akiofujita/ShaqJr/ShaqJr.docx

Shaq Jr Features

- heart rate
- respiratory rate
- time
- stopwatch
- timer
- plot heart rate
- 8-bit tones
- steps
- calories
- distance traveled
- gps
- mic
- blue tooth - notifications
- humidity
- ambient temperature
- skin temperature
- ambient light?
- Mp3 ?
