akiofujita/ShaqJr/Hardware/Bottom/ShaqJr-BOTTOM-BOM.xlsx

Design Name -- Revision Code / Designer |  |  |  |  |  |  |  |  |  |  | Total | $0.00 | Total (in Bulk) | $0.00
BOM # | Comment | Designator | Description | Mounting Type | Package | Manufacturer | Manufacturer Part Number | Supplier | Supplier Part Number | Price per unit | Quantity | Total | Per 100 | Total
1 | 10k resistor | R12, R10, R11 |  |  |  |  |  |  |  |  | 3
2 | 220k resistor | R1, R3, R5, R6 |  |  |  |  |  |  |  |  | 4
3 | 1M resistor | R2, R8 |  |  |  |  |  |  |  |  | 2
4 | 10M resistor | R4, R7 |  |  |  |  |  |  |  |  | 2
5 | unknown resistor | R9 |  |  |  |  |  |  |  |  | 1
6 | 2.2nF capactior | C7, C1 |  |  |  |  |  |  |  |  | 2
7 | 22nF capacitor | C5 |  |  |  |  |  |  |  |  | 1
8 | 100nF capacitor | C3, C6, C4, C10, C13, C12, C11 |  |  |  |  |  |  |  |  | 7
9 | 1uF capacitor | C14 |  |  |  |  |  |  |  |  | 1
10 | 2.2uF capacitor | C8, C9 |  |  |  |  |  |  |  |  | 2
11 | 22uF capacitor | C2 |  |  |  |  |  |  |  |  | 1
12 | crystal | Y1 |  |  |  |  |  |  |  |  | 1
13 | Trasnsitor | Q2 | NPN-GENERIC |  |  |  |  |  |  |  | 1
14 | TIA | TIA |  |  |  |  |  |  |  |  | 1
15 | LSM6DS3 | IMU1 | LSM6DS3_CAST |  |  |  |  |  |  |  | 1
16 | PCF8523 | U1 |  |  |  |  |  |  |  |  | 1
17 | AD5242 | AD5242 |  |  |  |  |  |  |  |  | 1
18 | AD5171 | AD5171 |  |  |  |  |  |  |  |  | 1
19 | Op Amp | OP2G$2, OP2G$3, OP2G$1, OP2G$4 |  |  |  |  |  |  |  |  | 2
20 | CONN_07-1.27MM | J1 |  |  |  |  |  |  |  |  | 1
21 | PPG Module connector | U$1 | Digi-key Part number: S9014E-50-ND |  |  |  |  |  |  |  | 1
