akiofujita/ShaqJr/Hardware/Top/ShaqJr-TOP-BOM.xlsx

Design Name -- Revision Code / Designer |  |  |  |  |  |  |  |  |  |  | Total | $0.00 | Total (in Bulk) | $0.00
BOM # | Comment | Designator | Description | Mounting Type | Package | Manufacturer | Manufacturer Part Number | Supplier | Supplier Part Number | Price per unit | Quantity | Total | Per 100 | Total
1 | 0 resistor | R16, R17 |  |  |  |  |  |  |  |  | 2
2 | 27 resistor | R11, R12 |  |  |  |  |  |  |  |  | 2
3 | 1k resistor | R7, R8, R14, R15 |  |  |  |  |  |  |  |  | 4
4 | 5k resistor | R4 |  |  |  |  |  |  |  |  | 1
5 | 10k resistor | R1, R2, R10, R9 |  |  |  |  |  |  |  |  | 4
6 | 100k resistor | R3, R5, R6 |  |  |  |  |  |  |  |  | 3
7 | 390k resistor | R13 |  |  |  |  |  |  |  |  | 1
8 | 47p capacitor | C10, C11 |  |  |  |  |  |  |  |  | 2
9 | 100nF capacitor | C13, C9 |  |  |  |  |  |  |  |  | 2
10 | 1uF capacitor | C2, C3, C6 |  |  |  |  |  |  |  |  | 3
11 | 2.2uF capacitor | C16, C14, C17, C18, C15 |  |  |  |  |  |  |  |  | 5
12 | 4.7uF capcitor | C1, C8 |  |  |  |  |  |  |  |  | 2
13 | 10uF capacitor | C4, C12 |  |  |  |  |  |  |  |  | 2
14 | unknown capcitor | C5, C7 |  |  |  |  |  |  |  |  | 2
15 | 10uH Inductor | L1 |  |  |  |  |  |  |  |  | 1
16 | Schottky diode | D1, D2, D3 | SCHOTTKY-USC |  |  |  |  |  |  |  | 3
17 | crystal | Y1 |  |  |  |  |  |  |  |  | 1
18 | red LED | LED1, LED3 |  |  |  |  |  |  |  |  | 2
19 | blue LED | LED2 |  |  |  |  |  |  |  |  | 1
20 | yellow LED | LED4 |  |  |  |  |  |  |  |  | 1
21 | nRF52832 module | U1 | Bluetooth module |  |  |  |  |  |  |  | 1
22 | FT231XS | U2 | FTDI Serial-to-USB Converter |  |  |  |  |  |  |  | 1
23 | OLED | U3 | Display |  |  |  |  |  |  |  | 1
24 | MIC5504 | LDO1 | MIC5504 Voltage Regulator |  |  |  |  |  |  |  | 1
25 | Micro USB Pad | USB1 | USB.MICRO-BIGGERPADS |  |  |  |  |  |  |  | 1
26 | MCP73831 | CHRG1 |  |  |  |  |  |  |  |  | 1
27 | CONN_02 | J1 |  |  |  |  |  |  |  |  | 1
28 | CONN_07-1.27MM | J2 |  |  |  |  |  |  |  |  | 1
29 | JUMPER-SMT_2_NO_SILK | JP1 |  |  |  |  |  |  |  |  | 1
30 | CORTEX_DEBUG_PTH | DEBUG1 |  |  |  |  |  |  |  |  | 1
31 | Button Gullwig | SW1, RESET |  |  |  |  |  |  |  |  | 2
32 | Buttons MOM | SW3, SW4 |  |  |  |  |  |  |  |  | 2
