akiofujita/ShaqJr/Hardware/Bottom/ShaqJr-BOTTOM.brd

## EAGLE design Hardware/Bottom/ShaqJr-BOTTOM.brd (2020-07-17)

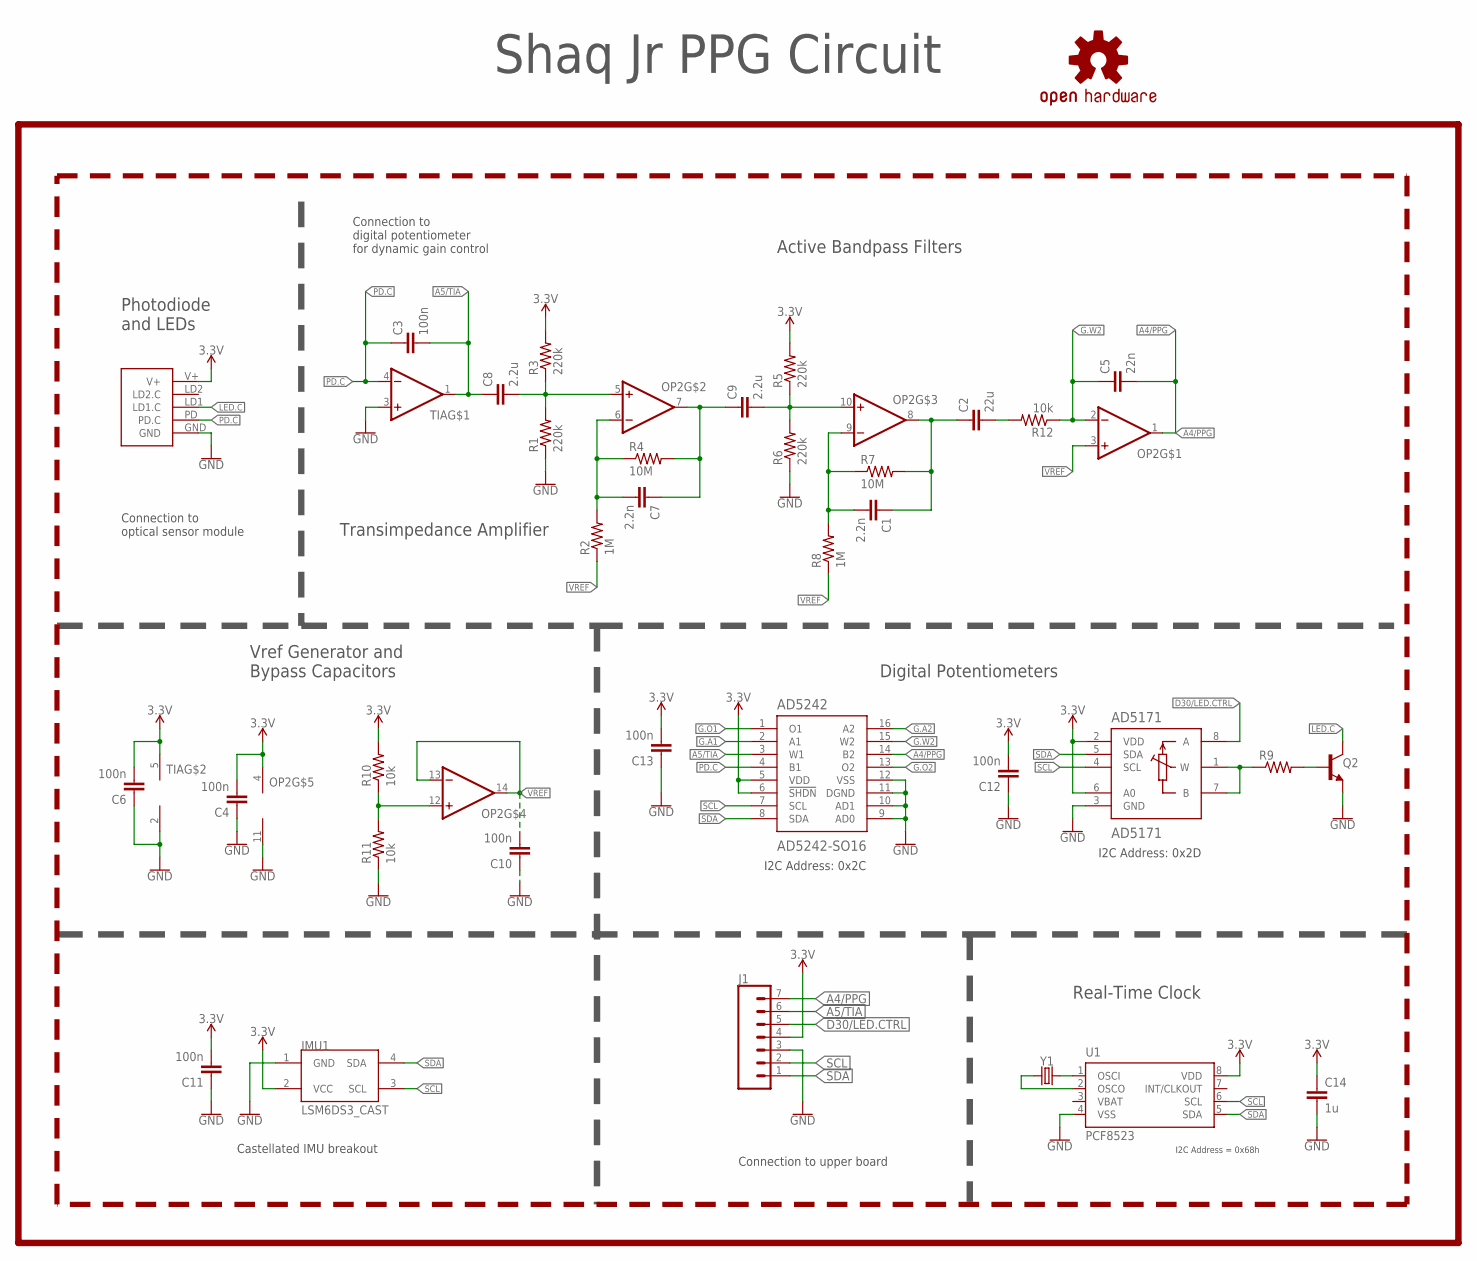
[picture p10: schematic ShaqJr-BOTTOM.sch]

Parts:
AD5171: AD5171; SOT-23-8
AD5242: AD5242-SO16; SO16
C1, C7: 2.2n; C0603
C2: 22u; C0603
C3, C4, C6, C10, C11, C12, C13: 100n; C0603
C5: 22n; C0603
C8, C9: 2.2u; C0603
C14: 1u; C0603
IMU1: LSM6DS3_CAST
J1: CONN_07-1.27MM; 1X07_1.27MM
LOGO1: REVISION.A; REV.A
LOGO2: OSHW-LOGOS; OSHW-LOGO-S
OP2: OP-QUAD-SO14; SO14
Q2: NPN-GENERIC; SOT23-3
R1, R3, R5, R6: 220k; R0603
R2, R8: 1M; R0603
R4, R7: 10M; R0603
R9: RESISTOR0603; R0603
R10, R11: 10k; R0402
R12: 10k; R0603
TIA: OP-SINGLEOT; SOT23-5
U1: PCF8523; SO8; DIGIKEY 568-5306-1-ND
U$1: PPG.MODULE.2
Y1: 32.7680kHz; 2-SMD.NOLEAD.2.0MMTO1.2MM

Connections:
3.3V: AD5171.2 (VDD), AD5171.6 (A0), AD5242.5 (VDD), AD5242.6 (!SHDN), C4.2, C6.2, C11.2, C12.2, C13.2, C14.1, IMU1.2 (VCC), J1.4, OP2.4 (V+), R3.2, R5.2, R10.2, TIA.5 (V+), U1.8 (VDD), U$1.V+
A4/PPG: AD5242.14 (B2), C5.2, J1.7, OP2.1 (OUT)
A5/TIA: AD5242.3 (W1), C3.2, C8.1, J1.6, TIA.1 (OUT)
D30/LED.CTRL: AD5171.8 (A), J1.5
G.A1: AD5242.2 (A1)
G.A2: AD5242.16 (A2)
G.O1: AD5242.1 (O1)
G.O2: AD5242.13 (O2)
G.W2: AD5242.15 (W2), C5.1, OP2.2 (-IN), R12.1
GND: AD5171.3 (GND), AD5242.9 (AD0), AD5242.10 (AD1), AD5242.11 (DGND), AD5242.12 (VSS), C4.1, C6.1, C10.1, C11.1, C12.1, C13.1, C14.2, IMU1.1 (GND), J1.3, OP2.11 (V-), Q2.2 (E), R1.1, R6.1, R11.1, TIA.2 (V-), TIA.3 (+IN), U1.4 (VSS), U$1.GND
LED.C: Q2.3 (C), U$1.LD1 (LD1.C)
unnamed: C8.2, OP2.5 (+IN), R1.2, R3.1
unnamed: C9.2, OP2.10 (+IN), R5.1, R6.2
unnamed: C7.2, OP2.6 (-IN), R2.2, R4.1
unnamed: C7.1, C9.1, OP2.7 (OUT), R4.2
unnamed: C1.2, OP2.9 (-IN), R7.1, R8.2
unnamed: C1.1, C2.1, OP2.8 (OUT), R7.2
unnamed: C2.2, R12.2
unnamed: U1.2 (OSCO), Y1.P$1 (1)
unnamed: U1.1 (OSCI), Y1.P$2 (2)
unnamed: Q2.1 (B), R9.2
unnamed: AD5171.1 (W), AD5171.7 (B), R9.1
unnamed: OP2.12 (+IN), R10.1, R11.2
PD.C: AD5242.4 (B1), C3.1, TIA.4 (-IN), U$1.PD (PD.C)
SCL: AD5171.4 (SCL), AD5242.7 (SCL), IMU1.3 (SCL), J1.2, U1.6 (SCL)
SDA: AD5171.5 (SDA), AD5242.8 (SDA), IMU1.4 (SDA), J1.1, U1.5 (SDA)
VBAT: U1.3 (VBAT)
VREF: C10.2, OP2.3 (+IN), OP2.13 (-IN), OP2.14 (OUT), R2.1, R8.1

Notes on the sheet:
Photodiode and LEDs
Active Bandpass Filters
Digital Potentiometers
Transimpedance Amplifier
I2C Address: 0x2C
I2C Address: 0x2D
Connection to optical sensor module
Connection to digital potentiometer for dynamic gain control
Connection to upper board
Castellated IMU breakout
Vref Generator and Bypass Capacitors
Shaq Jr PPG Circuit
Real-Time Clock
I2C Address = 0x68h

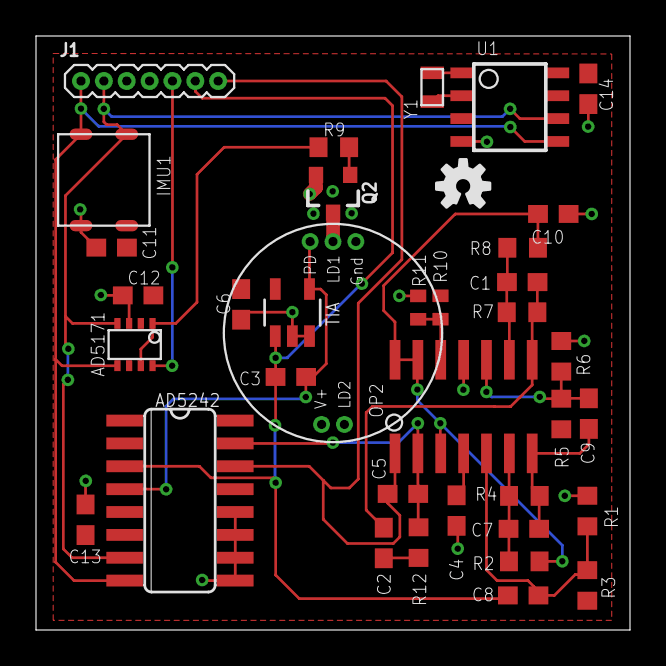
[picture p11: board ShaqJr-BOTTOM.brd from above]

Board: 2 copper layers, 33.0 x 33.0 mm, 38 parts (0 on the bottom side), 23 nets.
