akiofujita/ShaqJr/Hardware/PPG-Module/ShaqJr.brd

## EAGLE design Hardware/PPG-Module/ShaqJr.brd (2020-06-04)

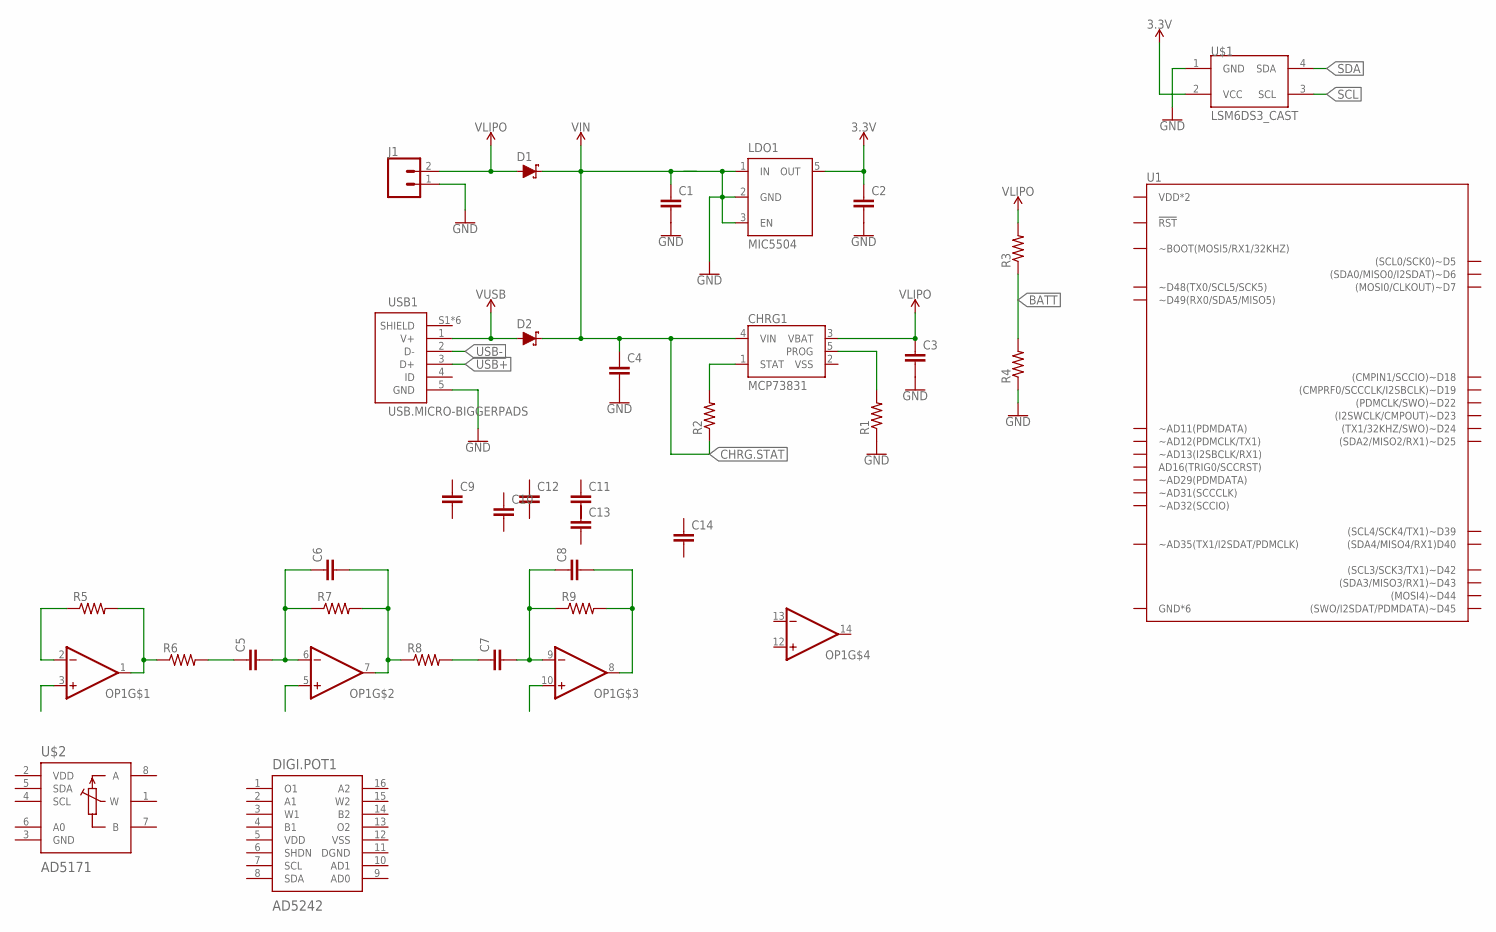
[picture p12: schematic ShaqJr.sch]

Parts:
C1, C2, C3, C4, C5, C6, C7, C8, C9, C10, C11, C12, C13, C14: CAPACITOR0603; C0603
CHRG1: MCP73831; SOT23-5
D1, D2: SCHOTTKY-USC; USC
DIGI.POT1: AD5242; TSSOP16
J1: CONN_02; 1X02
LDO1: MIC5504; SOT23-5
OP1: OP-QUAD-SO14; SO14
R1, R2, R3, R4, R5, R6, R7, R8, R9: RESISTOR0603; R0603
U1: ARTEMIS.CAST; ARTEMIS_CAST
U$1: LSM6DS3_CAST
U$2: AD5171; SOT-23-8
USB1: USB.MICRO-BIGGERPADS; USB-MICRO-01.BIGGERPADS

Connections:
3.3V: C2.1, LDO1.5 (OUT)
BATT: R3.1, R4.2
CHRG.STAT: C1.1, C4.1, CHRG1.4 (VIN), D1.- (C), D2.- (C), R2.1
GND: C1.2, C2.2, C3.2, C4.2, J1.1, LDO1.1 (IN), LDO1.2 (GND), LDO1.3 (EN), R1.1, R4.1, USB1.5 (GND)
unnamed: OP1.2 (-IN), R5.1
unnamed: OP1.1 (OUT), R5.2, R6.1
unnamed: CHRG1.5 (PROG), R1.2
unnamed: CHRG1.1 (STAT), R2.2
unnamed: C5.1, R6.2
unnamed: C5.2, C6.1, OP1.6 (-IN), R7.1
unnamed: C7.1, R8.2
unnamed: C6.2, OP1.7 (OUT), R7.2, R8.1
unnamed: C7.2, C8.1, OP1.9 (-IN), R9.1
unnamed: C8.2, OP1.8 (OUT), R9.2
SCL: U$1.3 (SCL)
SDA: U$1.4 (SDA)
USB+: USB1.3 (D+)
USB-: USB1.2 (D-)
V+: OP1.4 (V+)
V-: OP1.11 (V-)
VLIPO: C3.1, CHRG1.3 (VBAT), D1.+ (A), J1.2, R3.2
VSS: CHRG1.2 (VSS)
V_USB: D2.+ (A), USB1.1 (V+)

Board: 2 copper layers, 34 parts (0 on the bottom side), 16 nets, no tracks yet.
