akiofujita/ShaqJr/(commit log)

2020-02-02 Adding hardware and firmware folders- arduino and sch and brd files
    [ShaqJr.brd, ShaqJr.sch]
2020-04-18 added smartwatch-top and smartwatch-bottom files for EAGLE
    [smartwatch-bottom.brd, smartwatch-bottom.sch, smartwatch-top.brd, smartwatch-top.sch]
2020-05-28 features list
    [smartwatch-top.brd, smartwatch-top.sch]
2020-06-04 Added top, bottom, pcb module folders
    [smartwatch-bottom.brd, smartwatch-bottom.sch, smartwatch-top.brd, smartwatch-top.sch]
2020-06-04 adding ppg-module once again
    [ShaqJr.brd, ShaqJr.sch]
2020-06-04 added BOM files
    [ShaqJr-BOTTOM-BOM.xlsx, ShaqJr-PPG-MODULE-BOM.xlsx, ShaqJr-TOP-BOM.xlsx]
2020-06-04 deleted unnecessary files
    [ShaqJr.brd, ShaqJr.sch, smartwatch-bottom.brd, smartwatch-bottom.sch, smartwatch-top.brd, smartwatch-top.sch]
2020-06-18 Finished Take003
    [smartwatch-bottom.brd, smartwatch-bottom.sch, smartwatch-top.brd, smartwatch-top.sch]
2020-06-18 Rename smartwatch-top.sch to ShaqJr-TOP.sch
    Renamed file to align with instructions
    [ShaqJr-TOP.sch]
2020-06-18 Rename smartwatch-top.brd to ShaqJr-TOP.brd
    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
    [ShaqJr-TOP.brd]
2020-06-18 Rename smartwatch-bottom.brd to ShaqJr-BOTTOM.brd
    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
    [ShaqJr-BOTTOM.brd]
2020-06-18 Rename smartwatch-bottom.sch to ShaqJr-BOTTOM.sch
    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
    [ShaqJr-BOTTOM.sch]
2020-07-10 completed take 007, may need to review polygons- gnd and 3.3v
    [ShaqJr-BOTTOM.brd, ShaqJr-BOTTOM.sch, ShaqJr-TOP.brd, ShaqJr-TOP.sch]
2020-07-17 Finished Take 008
    [ShaqJr-BOTTOM.brd, ShaqJr-BOTTOM.sch, ShaqJr-TOP.brd, ShaqJr-TOP.sch]
2020-08-13 Added ppg module brd, sch and bom, and ex ino code
    [ShaqJr-BOTTOM.sch, ShaqJr-PPG-MODULE-BOM.xlsx, ShaqJr-PPG-Module.brd, ShaqJr-PPG-Module.sch]
2020-08-14 Added basic list for BOM
    [ShaqJr-BOTTOM-BOM.xlsx, ShaqJr-TOP-BOM.xlsx]
2020-08-14 Organized BOM parts in a more reasonable order and added quantities
    [ShaqJr-BOTTOM-BOM.xlsx, ShaqJr-TOP-BOM.xlsx]
